superkaiyu/Robot_t-l-guider/README.md

# Robot téléguidé — 2 ESP32 + GPS + IHM, tout en WiFi

```
                          WiFi "ROBOT_ESP32" (créé par le robot, 192.168.4.1)
   ┌──────────────────────┐   UDP 4210, 25×/s : joystick + bouton     ┌───────────────────────────┐
   │ ESP32 MANETTE (XIAO)  │ ────────────────────────────────────────▶ │ ESP32 ROBOT (S3 N16R8)     │
   │ joystick (breadboard) │ ◀──────────────────────────────────────── │ driver moteurs + batterie  │
   └──────────────────────┘   réponse : qui pilote + position GPS    │                            │
                                                                     │  ▲ UART (fil TX du GPS)    │
   ┌──────────────────────┐   http://192.168.4.1  (page de l'IHM)    │  │                         │
   │ PC / téléphone        │ ◀──────────────────────────────────────── │ GPS Air530                 │
   │ IHM dans navigateur   │ ◀══ WebSocket port 81, 20×/s ══════════▶ │                            │
   └──────────────────────┘   télémétrie ⇄ commandes, ping           └───────────────────────────┘
```

- Le **robot** crée le réseau WiFi `ROBOT_ESP32` (mot de passe `motdepasse123`). Tout le monde s'y connecte : il n'y a besoin d'aucune box ni d'Internet.
- Le **GPS** est branché au robot par un fil série. Le robot décode la position et la diffuse en WiFi à l'IHM **et** à la Manette.
- La **Manette** envoie son joystick au robot 25×/s en UDP et reçoit en retour la position GPS (affichée dans son Moniteur Série).
- L'**IHM** est servie par le robot lui-même : ouvrir **http://192.168.4.1** suffit, elle se connecte toute seule en **WebSocket** (connexion permanente : le robot pousse la télémétrie 20×/s, les commandes partent dès qu'elles changent, la latence est affichée en haut à droite).

> **À propos du GPS :** un module GPS calcule sa position en *écoutant* les satellites (il n'émet rien vers eux). Cette partie est inévitable : **en intérieur, pas de position**. En revanche, tout le transport des données (GPS → ESP32 → IHM / Manette) passe uniquement par le fil série et le WiFi de l'ESP32. L'IHM affiche clairement si le module est **non détecté** (câblage), **en recherche** (câblé et OK, mais pas encore de ciel) ou a une **position acquise**.
> Pour tester toute la chaîne en intérieur, mettre `#define GPS_SIMULATION 1` dans `robot/robot.ino` : le robot envoie alors une fausse position (cercle de 10 m) marquée « Simulation ».

## Contenu

| Fichier | Rôle |
|---|---|
| `robot/robot.ino` | ESP32 **Robot** (ESP32-S3 N16R8) : point d'accès WiFi, GPS, moteurs, télémétrie, sert l'IHM |
| `robot/gps_detection.h`, `robot/gps_filtre.h`, `robot/gps_satellites.h` | Détection automatique du GPS, filtre de position, signal de chaque satellite |
| `robot/journal.h` | Enregistrement de chaque session dans la mémoire du robot |
| `robot/ws_serveur.h` | Mini serveur WebSocket (aucune bibliothèque à installer) |
| `robot/ihm_html.h` | IHM compressée embarquée dans le robot (**générée**, ne pas modifier à la main) |
| `robot/secrets_exemple.h` | Modèle pour les réseaux WiFi externes optionnels |
| `manette/manette.ino` | ESP32 **Manette** (Seeed XIAO ESP32S3) : joystick → robot, reçoit le GPS |
| `ihm/ihm.html` | Source de l'IHM (peut aussi être ouverte directement sur le PC) |
| `televerser_robot.bat`, `televerser_manette.bat`, `televerser_tout.bat`, `lister_esp32.bat` | Double-clic sous Windows : téléverse sur le bon ESP32 |
| `tools/televerser.py` | Le script appelé par les `.bat` (détecte quel port COM est quelle carte) |
| `tools/sessions.py`, `sessions_recuperer.bat` | Récupère les sessions du robot dans une base de données SQLite sur le PC |
| `tools/generer_ihm_h.py` | Régénère `robot/ihm_html.h` après une modification de l'IHM |

## Câblage

### Principe de la breadboard

- Les 5 trous d'une même rangée (a–e ou f–j) sont reliés entre eux. La rainure du milieu sépare les deux côtés.
- Les longues lignes des bords (rouge +, bleue −) sont des **rails** : un rail **3V3** (rouge) et un rail **masse** (bleu).
- La carte se pose à cheval sur la rainure : chaque broche tombe dans sa propre rangée. Pour la relier, plante un fil dans un des 4 autres trous de la même rangée, du même côté.

### ESP32 Robot : ESP32-S3 N16R8 (DevKitC-1)

Alimentation : **GND → rail bleu**, **3V3 → rail rouge**, câble USB-C sur le port marqué **UART** (PC, chargeur ou batterie externe).

| Élément | Branchement |
|---|---|
| **GPS** | **TX du module → GPIO14**, VCC → rail rouge, GND → rail bleu. Le RX du module reste libre. |
| LED de statut | GPIO21 → résistance 220–330 Ω → patte longue de la LED ; patte courte → rail bleu |
| Tension batterie | Pont diviseur : 30 kΩ entre le **+ batterie** et une rangée libre, 10 kΩ entre cette rangée et le rail bleu. Cette rangée → **GPIO1**. Le + batterie ne touche **jamais** directement un GPIO. |
| Courant | GPIO2. Sans capteur de courant, relier GPIO2 au rail bleu. |
| Carte moteur L298N | Voir le paragraphe suivant (6 fils sur P3 + la masse commune) |

Une roue tourne à l'envers ? Dans `robot.ino`, passe `INVERSER_ROUE_G` ou `INVERSER_ROUE_D` à `true`.

### Carte de commande moteur L298N (GEII Angoulême, module R1)

À choisir avec `#define DRIVER_MOTEUR DRIVER_L298` dans `robot.ino`. Le L298N contient deux ponts en H : **M1 = roue gauche** (sortie P2 « Moteur1 »), **M2 = roue droite** (sortie P4 « Moteur2 »). Pour chaque moteur, **EN** reçoit la PWM (la vitesse) et **I1 / I2** donnent le sens, comme dans la table de vérité du L298 :

| EN | I1 | I2 | Moteur |
|---|---|---|---|
| PWM | 1 | 0 | avant |
| PWM | 0 | 1 | arrière |
| 0 | x | x | roue libre (arrêt) |

**Connecteur P3 « Commande moteur »** (bornier vert à 6 points, dans l'ordre imprimé sur la carte) :

| Point P3 | Signal | Couleur conseillée | Broche ESP32-S3 |
|---|---|---|---|
| I2 (M2) | sens roue droite | vert | **GPIO18** |
| I1 (M2) | sens roue droite | jaune | **GPIO17** |
| EN (M2) | vitesse roue droite (PWM) | blanc | **GPIO9** |
| EN (M1) | vitesse roue gauche (PWM) | blanc | **GPIO8** |
| I1 (M1) | sens roue gauche | jaune | **GPIO15** |
| I2 (M1) | sens roue gauche | vert | **GPIO16** |

Sur la DevKitC-1, GPIO15, 16, 17, 18 et 8 sont côte à côte sur le même bord ; GPIO9 est trois broches plus loin (après GPIO3 et GPIO46).

**Connecteur P1 « Alimentation »** (GND · Vcc · GND) :

- **Vcc = 5 à 7 V au maximum, 6 V conseillés.** Sur cette carte, le même Vcc alimente les moteurs (VS) **et** la logique du L298 (VSS, 7 V maximum). La batterie 3S (12 V) ne doit donc **pas** aller directement sur Vcc : passer par un module abaisseur de tension (« buck », type LM2596, au moins 2 A) réglé sur 6 V, ou utiliser 4 piles AA, ou une alimentation de labo à 6 V avec limite de courant.
- Un GND reçoit le − de l'alimentation, **l'autre GND va au rail bleu de l'ESP32**. P3 n'a pas de masse : sans ce fil, les commandes ne passent pas.

**À savoir :**

- Les entrées du L298 acceptent directement le 3,3 V de l'ESP32 (niveau haut dès 2,3 V) : pas d'adaptateur de niveau.
- EN est tiré à la masse par 10 kΩ (R1, R4) : un fil EN débranché = moteur arrêté. C'est la première chose à vérifier si un moteur ne tourne pas.
- Le L298 perd environ 2 V : avec 6 V sur Vcc, le moteur reçoit environ 4 V. En dessous de 25 % de puissance le moteur siffle sans tourner ; le programme saute donc cette zone (`PUISSANCE_MIN_MOTEUR = 25`).
- PWM à 1 kHz (`FREQUENCE_PWM_MOTEURS`) : le L298 commute lentement et chaufferait plus vite. Le léger sifflement des moteurs est normal.
- Mesure de batterie : le pont diviseur reste branché sur le + de la batterie 3S (avant le module abaisseur). Avec 4 piles AA à la place, abaisser `SEUIL_SOUS_TENSION_PACK` (vers 4,4 V) et `SEUIL_SURTENSION_PACK` (vers 6,6 V) dans `robot.ino`, sinon l'IHM affiche « SOUS-TENSION » (les moteurs tournent quand même).
- Les diodes D1 à D8 (1N5819) protègent déjà le L298 des pointes de tension des moteurs.
- Les résistances R2/R3 et R5/R6 (mesure de courant du L298) ne sortent sur aucun connecteur : sans capteur séparé, relier GPIO2 au GND.

**Pour faire tourner un seul moteur** (premier essai) : P1 (6 V + GND), le fil de masse vers l'ESP32, les 3 fils de M1 (GPIO15 → I1, GPIO16 → I2, GPIO8 → EN) et le moteur sur P2. Robot sur cales, ouvrir le Moniteur Série (115200 bauds) et taper **`t`** : chaque moteur tourne 1,5 s en avant puis 1,5 s en arrière à 60 %. Ensuite, piloter depuis l'IHM.

**Autre driver** : avec un petit TB6612FNG ou DRV8833, mettre `#define DRIVER_MOTEUR DRIVER_TB6612` : GPIO15/16 → AIN1/AIN2 (roue gauche), GPIO17/18 → BIN1/BIN2 (roue droite), PWM à 20 kHz, VCC/STBY/PWMA/PWMB (TB6612) ou nSLEEP (DRV8833) au 3V3.

Sans batterie branchée sur le pont diviseur, l'IHM affiche la batterie « NON BRANCHÉE » (pas d'alarme).

**Arduino IDE (Robot)** : carte **ESP32S3 Dev Module** ; *USB CDC On Boot : Disabled* (le Moniteur Série passe par le port UART) ; *Flash Size : 16MB* ; *PSRAM : OPI PSRAM* ; *Partition Scheme : Huge APP (3MB No OTA/1MB SPIFFS)* (il faut un espace de fichiers pour enregistrer les sessions). Le même `robot.ino` fonctionne encore sur une XIAO ESP32S3 : le brochage est choisi selon la carte sélectionnée.

**Détection automatique du GPS** : au démarrage, le Robot cherche tout seul sur quelle broche arrive le fil TX du GPS (**GPIO14**, puis les broches libres voisines GPIO13, 12, 11, 10, 4, 5, 6, 7) et à quelle vitesse il parle (9600, 115200, 38400, 57600, 19200, 4800 bauds). Il vérifie que ce sont de vraies trames GPS (NMEA avec somme de contrôle), puis retient la combinaison trouvée pour le démarrage suivant. Si le GPS est débranché puis rebranché, il le retrouve (nouvel essai toutes les 10 s). Le résultat s'affiche :

- dans le Moniteur Série du robot : `[GPS] ✅ Module GPS détecté sur GPIO14 à 9600 bauds.` ;
- dans l'IHM, onglet **GPS** (« Branché sur : GPIO14 · 9600 bauds »), avec un bouton **Relancer la détection du GPS** ;
- avec `lister_esp32.bat` : `COM5  ROBOT … GPS : module OK, recherche des satellites — branché sur GPIO14 à 9600 bauds`.

Commandes à taper dans le Moniteur Série du robot (115200 bauds) : `?` identité + état du GPS, `g` afficher les trames GPS brutes (marche/arrêt), `d` relancer la détection, `t` tester les moteurs un par un.

### Modules LMD18200T (un par roue)

Réglage actuel du programme : `#define DRIVER_MOTEUR DRIVER_LMD18200`. Le LMD18200T est un pont en H complet (3 A, jusqu'à 55 V) : il faut **un module par roue**. Les broches de l'ESP32 sont les mêmes que pour la carte L298N, seuls leurs rôles changent.

| Signal du module | Roue gauche | Roue droite | Rôle |
|---|---|---|---|
| DIR (patte 3 du LMD18200) | **GPIO15** | **GPIO17** | sens : 1 = avant, 0 = arrière |
| BRAKE (patte 4) | **GPIO16** | **GPIO18** | 0 = roule, 1 avec PWM à 0 = roue libre |
| PWM (patte 5) | **GPIO8** | **GPIO9** | vitesse |
| GND (patte 7) | GND de l'ESP32 | GND de l'ESP32 | masse commune obligatoire |
| VS (patte 6) | + 12 V | + 12 V | puissance des moteurs |
| OUTPUT 1 et 2 (pattes 2 et 10) | moteur gauche | moteur droit | |

Pattes du LMD18200T (boîtier à 11 pattes, marquage face à soi, de gauche à droite) : 1 bootstrap 1 · 2 sortie 1 · 3 DIR · 4 BRAKE · 5 PWM · 6 VS · 7 GND · 8 mesure de courant · 9 alarme température · 10 sortie 2 · 11 bootstrap 2. Les deux condensateurs bleus (10 nF, pattes 1-2 et 10-11) sont déjà soudés sur le module. Pour savoir quel point des connecteurs du module va à quelle patte, lire la sérigraphie ou tester au multimètre (mode bip, module débranché).

**Alimentation** : VS entre 12 et 55 V. En dessous d'environ 10 V, le LMD18200 se coupe tout seul (protection). Une batterie 3S chargée (11 à 12,6 V) convient ; pour les tests, une alimentation de labo à 12 V limitée à 1 ou 2 A. Les moteurs reçoivent presque toute la tension : avec des moteurs 6 V, garder « Puissance max » à 50 % au plus dans l'IHM.

**À savoir** : les entrées acceptent le 3,3 V de l'ESP32 (niveau haut dès 2 V). PWM à 20 kHz, inaudible. À l'arrêt, le programme met BRAKE à 1 et PWM à 0 : roue libre. Mesure de courant facultative : la patte 8 sort 377 µA par ampère dans la résistance du module ; reliée à GPIO2, régler `COURANT_AMPERES_PAR_VOLT = 1 / (0.000377 × R)` (par exemple 1,2 pour R = 2,2 kΩ). Test : taper `t` dans le Moniteur Série, robot sur cales.

### ESP32 Manette : Seeed XIAO ESP32S3

La XIAO se pose à cheval sur la rainure (D0 à D10 sont imprimés sur la carte), alimentée par son propre câble USB-C.

| Élément | Broche XIAO | GPIO |
|---|---|---|
| Joystick +5V / VCC | **3V3** (même si le module indique 5V) | — |
| Joystick GND | GND | — |
| Joystick VRx | D2 | 3 |
| Joystick VRy | D10 | 9 |
| Joystick SW (bouton) | D6 | 43 |
| LED statut (via 220–330 Ω, cathode vers GND) | D5 | 6 |

**Arduino IDE (Manette)** : carte **XIAO_ESP32S3**, *USB CDC On Boot : Enabled*.

### Ordre conseillé

1. Câble le Robot **sans** les moteurs ni la batterie, téléverse-le et vérifie l'IHM sur http://192.168.4.1.
2. Câble la Manette et vérifie qu'elle se connecte au robot (LED fixe, pastille « ESP32 Manette » verte).
3. Branche la carte moteur et les moteurs en dernier, avec une alimentation réglée à 6 V et une limite de courant basse, puis tape `t` dans le Moniteur Série pour les tester.

## Téléverser les deux ESP32 (un seul port USB du PC)

Branche les deux cartes sur un **hub USB** (ou deux ports) : le Robot par son port USB-C **UART**, la Manette par son USB-C. Chaque carte a un numéro de série unique : Windows lui donne **son propre port COM** (par ex. COM5 et COM7), toujours le même ensuite. Rien à régler dans les cartes.

**Méthode automatique (recommandée)** — il faut seulement Python (https://www.python.org, cocher « Add to PATH ») et l'Arduino IDE 2 déjà utilisé :

1. Double-clic sur **`televerser_tout.bat`** (ou `televerser_robot.bat` / `televerser_manette.bat`).
2. Le script demande « ? » à chaque carte, qui répond `ID=ROBOT` ou `ID=MANETTE`, puis compile et téléverse le bon programme sur le bon port. Il utilise l'`arduino-cli` intégré à l'Arduino IDE : mêmes cartes, mêmes bibliothèques, et la bonne carte pour chaque programme (ESP32-S3 N16R8 pour le Robot, XIAO pour la Manette).
3. La toute première fois (cartes pas encore programmées), il te demande laquelle est laquelle, puis s'en souvient (`tools/cartes_esp32.json`).

`lister_esp32.bat` affiche simplement quel COM est le Robot et lequel est la Manette. En ligne de commande : `python tools/televerser.py moniteur robot` ouvre le Moniteur Série d'une carte.

**Méthode manuelle dans l'Arduino IDE** : ouvre `robot.ino` et `manette.ino` dans **deux fenêtres** de l'IDE. Dans chaque fenêtre, choisis la bonne carte (**ESP32S3 Dev Module** pour le Robot, **XIAO_ESP32S3** pour la Manette, réglages ci-dessus) et le port de la bonne carte (*Outils › Port*). Pour savoir quel COM est quelle carte, ouvre le Moniteur Série (115200 bauds), tape `?` puis Entrée : la carte répond `ID=ROBOT` ou `ID=MANETTE`. Tu peux aussi débrancher une carte et regarder quel port disparaît.

> ⚠️ Utilise le bouton **Téléverser (→)** et non **Déboguer** (icône insecte). Le débogueur lance OpenOCD sur l'interface JTAG, d'où l'erreur `LIBUSB_ERROR_ACCESS … esp_usb_jtag: could not find or open device` : ce n'est pas nécessaire pour programmer la carte.
>
> Si un téléversement échoue : ferme le Moniteur Série ouvert sur ce port. Si la carte ne répond plus, maintiens **BOOT**, appuie sur **RESET**, relâche **BOOT**, puis relance.

## Mise en route

1. **Arduino IDE** : installer le paquet de cartes *esp32* (Espressif) et la bibliothèque **TinyGPSPlus** (Mikal Hart). Réglages des cartes : voir « Câblage » ci-dessus.
2. *(Optionnel)* copier `robot/secrets_exemple.h` en `robot/secrets.h` et y mettre les mots de passe de tes réseaux (box, partage de connexion, WIFI-UP). Ce fichier n'est jamais envoyé sur GitHub. Sans lui, le robot fonctionne avec son seul point d'accès.
3. Téléverser les deux cartes (voir ci-dessus). *Ne pas toucher le joystick pendant la première seconde : sa position de repos est calibrée au démarrage.*
4. Connecter le PC ou le téléphone au WiFi **ROBOT_ESP32**, puis ouvrir **http://192.168.4.1**.

Ce qu'on doit voir :

- Moniteur Série du robot : `[WiFi] ESP32 Manette connectée !`, `[WebSocket] IHM n°0 connectée`, puis toutes les 5 s une ligne `[GPS] etat=...`.
- Moniteur Série de la Manette : `[Robot] Liaison établie : commandes et GPS échangés.` puis chaque seconde la position GPS reçue.
- LED de la Manette : **fixe** = tout communique ; clignote lent = WiFi OK mais robot muet ; clignote vite = WiFi introuvable.
- IHM : les pastilles en haut (Robot, ESP32 Manette, GPS, latence ≈ quelques ms et « WebSocket · 20 msg/s »).

## L'IHM

- **Piloter depuis le PC** : PC connecté au WiFi `ROBOT_ESP32`, page http://192.168.4.1, puis **joystick virtuel** à glisser à la souris (ou au doigt sur téléphone), **clavier** (flèches ou ZQSD, les touches s'allument ; `+` / `−` pour la puissance ; *Espace* = arrêt d'urgence), ou **manette USB** branchée au PC. Si le robot ne suit pas, une ligne orange sous le joystick dit pourquoi (mode démo, pas de liaison, manette prioritaire, arrêt d'urgence).
- **Démarrage progressif des moteurs** : la puissance monte en 250 ms au lieu d'un coup, pour éviter la chute de tension qui faisait redémarrer l'ESP32. S'arrêter reste immédiat.
- **Barres Roue G / Roue D** : la puissance réellement appliquée par le robot (pas seulement celle demandée).
- **Qui pilote** : IHM, ESP32 Manette ou arrêt d'urgence, en direct.
- Onglets **Vue d'ensemble**, **GPS** (position, signal de chaque satellite et carte du ciel, trajet, liens OpenStreetMap / Google Maps), **Batterie**, **Roues**, **Système** (diagnostic des coupures et des redémarrages), **Sessions** (récapitulatif de chaque session, voir plus bas).
- Une petite coupure WiFi ne remet plus tout à zéro : l'IHM affiche « Signal faible » et grise les valeurs. La liaison n'est déclarée perdue qu'après 6 s.
- Si le robot redémarre, un bandeau l'indique avec la cause (par exemple « chute de tension »).
- Aucune bibliothèque externe : tout fonctionne sans Internet (seule la carte OpenStreetMap optionnelle en a besoin). Utilisable aussi sur téléphone.
- Si le robot a encore un ancien firmware (sans WebSocket), l'IHM repasse automatiquement en HTTP (« HTTP (secours) »).
- Robot non connecté : **mode démo** qui simule le robot.

## Qui pilote ?

Plusieurs sources peuvent être connectées en même temps. Le robot choisit, à chaque instant :

1. **Arrêt d'urgence** : bouton du joystick de la Manette, bouton rouge / *Espace* dans l'IHM, ou bouton B de la manette USB → coupe tout.
2. **ESP32 Manette**, dès que son stick est écarté du centre.
3. **IHM**.

Une source au repos ne bloque jamais les autres. Sans commande fraîche depuis 500 ms, les moteurs sont coupés.

## Protocoles

| Liaison | Format |
|---|---|
| Manette → Robot (UDP 4210) | `M,<rg>,<rd>,<jx>,<jy>,<bouton 0/1>,<rssi>` (rg/rd de -100 à 100) |
| Robot → Manette | `OK;pilote=...;gps=...;fix=0/1;lat=...;lon=...;sat=...` |
| IHM → Robot (WebSocket 81) | `c,<rg>,<rd>` commande · `stop` arrêt d'urgence · `p,<n>` ping · `h,<s depuis 1970>` heure du PC |
| Robot → IHM | JSON de télémétrie 20×/s · `P,<n>` réponse au ping |
| HTTP (secours / outils) | `/` IHM · `/cmd?src=ihm&rg=..&rd=..[&stop=1]` · `/telemetrie` · `/gps` · `/gps-detecter` · `/wifiup` · `/aide` · `/sessions` · `/session?id=N` · `/session-supprimer?id=N` (POST) · `/heure?e=..` |

## Sessions et base de données

Une **session**, c'est tout ce qui se passe entre l'allumage et l'extinction du robot. Le robot l'enregistre lui-même dans sa mémoire flash (`/sessions/000042.csv`, 42 = numéro de démarrage), même si aucune IHM n'est ouverte :

- une mesure par seconde quand le robot roule ou que le GPS se déplace, toutes les 5 s sinon : position GPS, satellites, HDOP, vitesse, tension et courant batterie, consommation, puissance des roues, qui pilote, présence de l'IHM et de la manette, signal WiFi le plus faible ;
- les événements : arrêt d'urgence, changement de pilote, manette / IHM connectée ou perdue, appareil qui quitte le WiFi, position GPS trouvée ou perdue, alerte batterie ;
- l'heure réelle, donnée par l'IHM à la connexion (le robot n'a pas d'horloge) ou lue sur le GPS.

L'écriture se fait toutes les 10 s : on perd au plus les 10 dernières secondes quand on coupe l'alimentation. La mémoire garde environ 60 sessions ; quand elle est pleine, les plus anciennes sont effacées.

**Dans l'IHM**, onglet **Sessions** : la liste, et pour chaque session un récapitulatif (durée, temps de conduite manette / IHM, distance et vitesse max GPS, batterie début → fin, consommation, % du temps avec une position GPS, arrêts d'urgence et coupures), le trajet, la courbe de batterie et la liste des événements. Le bouton *Télécharger le CSV* enregistre le fichier sur le PC, et *Ouvrir un fichier CSV* réaffiche plus tard une session déjà téléchargée. Pendant le téléchargement d'une session (1 à 2 s) le robot s'arrête par sécurité.

**Base de données sur le PC** : PC connecté au WiFi du robot, double-clic sur **`sessions_recuperer.bat`**. Toutes les nouvelles sessions sont copiées dans `sessions/sessions.db` (SQLite) et leurs CSV dans `sessions/csv/`. Le dossier `sessions/` reste sur le PC (il n'est pas envoyé sur GitHub). En ligne de commande :

```
python tools/sessions.py                 # récupère les nouvelles sessions du robot
python tools/sessions.py liste           # toutes les sessions de la base
python tools/sessions.py recap 42        # récapitulatif détaillé de la session 42
python tools/sessions.py importer f.csv  # ajoute un CSV téléchargé depuis l'IHM
python tools/sessions.py exporter 42     # mesures de la session 42 en CSV (pour Excel)
```

La base contient trois tables : `sessions` (une ligne de récapitulatif par session), `mesures` et `evenements`. Elle s'ouvre aussi avec *DB Browser for SQLite* pour faire ses propres requêtes. L'IHM et `sessions.py` utilisent les mêmes règles de calcul : une distance n'est comptée qu'au-delà de 2 m entre deux positions (bruit du GPS), et un trou de plus de 10 s dans l'enregistrement est ignoré.

Si l'onglet Sessions indique que le robot n'a pas d'espace pour enregistrer, c'est le *Partition Scheme* : choisir **Huge APP (3MB No OTA/1MB SPIFFS)** puis téléverser à nouveau (`televerser_robot.bat` le fait tout seul).

## Modifier l'IHM

Modifier `ihm/ihm.html`, puis `python tools/generer_ihm_h.py` et re-téléverser le robot. (`televerser_robot.bat` régénère le fichier automatiquement.)

## Dépannage GPS

| L'IHM affiche | Signification | Que faire |
|---|---|---|
| **Détection du module…** | Le robot essaie les broches / vitesses une par une | Attendre quelques secondes |
| **Module non détecté** | Rien reçu sur aucune des broches essayées, à aucune vitesse | Vérifier le fil TX du GPS → GPIO14 du Robot, VCC → 3V3 (ou 5V selon le module), GND commun, LED du module allumée |
| **Données illisibles** | Des caractères arrivent mais ne forment jamais de trames NMEA valides | Masse (GND) commune, vitesse du module inhabituelle |
| **Recherche · N satellites entendus** | Câblage OK, le module communique, pas encore de position | Aller dehors / près d'une fenêtre, attendre 1 à 5 min au premier démarrage |
| **Position acquise** | Tout fonctionne | — |

**Le tracé GPS bougeait tout seul, robot immobile ?** C'est normal pour un GPS : chaque mesure varie de 2 à 5 m dehors, et de 10 à 20 m en intérieur. Le robot filtre maintenant la position (`robot/gps_filtre.h`) :
- **moteurs arrêtés** : la position est moyennée pendant 30 s puis **figée**. Le trajet ne bouge plus, même si le GPS dérive de plusieurs dizaines de mètres (fréquent en intérieur) ou annonce une fausse vitesse de 1 à 3 km/h ;
- **mesures imprécises (HDOP > 8) et sauts aberrants** : ignorés ;
- **robot qui roule (moteurs), ou GPS vraiment porté à la main** (plus de 3,5 km/h pendant 5 s et au moins 4 m parcourus) : le trajet suit.

Dans l'onglet GPS, les points pâles montrent les mesures brutes (le bruit) ; la ligne est le trajet filtré.

## Précision du GPS

L'onglet **GPS › Réception des satellites** montre la force du signal (dB-Hz) de chaque satellite et sa position dans le ciel :

| Signal | Signification |
|---|---|
| ≥ 35 dB-Hz (vert) | très bon |
| 25 à 35 (orange) | moyen |
| < 25 (rouge) | trop faible pour servir |

Il faut au moins **4 satellites au-dessus de 30 dB-Hz** pour obtenir une position, et **6 ou plus** pour qu'elle soit précise.

Ce qui améliore la précision :

1. **Ciel dégagé** : loin des murs, des arbres et des toits. En intérieur, les signaux sont trop faibles.
2. **Antenne vers le ciel** : la face plate (céramique) du module vers le haut, jamais couverte par la main.
3. **GPS éloigné de l'électronique** : au moins 10 cm de l'ESP32, des moteurs et des câbles USB. Leur bruit électrique brouille le GPS (signaux qui chutent dans l'onglet).
4. **Temps** : laisse le GPS allumé 10 à 15 min. La précision s'améliore à mesure qu'il reçoit les informations des satellites.
5. **Alimentation stable** : chaque redémarrage du robot oblige le GPS à tout recommencer.
6. **Robot immobile** : la position est moyennée pendant 60 s, en donnant plus de poids aux mesures précises (HDOP faible, beaucoup de satellites).

Même dans de bonnes conditions, un module GPS d'entrée de gamme reste précis à **2 à 5 m** environ.

### Pourquoi le tracé partait à 100 m alors que le GPS ne bougeait pas

Avec des signaux sous 25 dB-Hz (tout en rouge dans l'onglet), le module calcule quand même une position et annonce un HDOP correct, mais cette position peut être fausse de 50 à 150 m et se promener. Ajoute à cela les premières positions après l'allumage (souvent très fausses) et les redémarrages du robot, et on obtient de grandes lignes droites sur le tracé. Le filtre du robot (`robot/gps_filtre.h`) fait maintenant :

- **au démarrage**, il attend que 10 mesures de suite soient d'accord entre elles (60 s au plus) et garde leur médiane (badge « stabilisation ») ;
- **signal faible** (moins de 4 satellites à 25 dB-Hz ou plus) : position figée tant que les moteurs ne tournent pas, précision affichée « ± 25 m (signal faible) » ;
- **sauts impossibles** : une mesure plus loin que ce qu'on peut parcourir à 3 m/s est ignorée. Si 10 mesures de suite sont ignorées et d'accord entre elles, le robot a vraiment été déplacé et on repart de là ;
- **porté à la main** : reconnu seulement si les mesures récentes se sont vraiment éloignées (plus de 8 m) et que le GPS mesure une vitesse.

L'IHM ne relie plus deux points séparés de plus de 30 m, ni l'avant et l'après d'un redémarrage : le trajet est coupé en morceaux au lieu de tracer une grande ligne droite.

**Le vrai remède reste le ciel dégagé** : dehors, loin des murs, antenne vers le haut. Aucun filtre ne peut retrouver la bonne position à partir de signaux trop faibles ; il peut seulement éviter d'afficher n'importe quoi.

## Coupures WiFi : trouver la cause

L'onglet **Système** de l'IHM affiche le diagnostic : coupures, signal WiFi de chaque appareil, redémarrages du robot et leur cause, et des conseils adaptés. Les causes les plus fréquentes :

| Ce que montre l'onglet Système | Cause | Solution |
|---|---|---|
| Redémarrages, cause « chute de tension » | Alimentation trop faible (pics de courant du WiFi ou des moteurs) | Batterie externe de qualité, câble USB court et épais. En dernier recours, baisser `PUISSANCE_WIFI` dans `robot.ino`. |
| Redémarrages, cause « mise sous tension » | La batterie externe se coupe toute seule (consommation trop faible) | Batterie externe sans arrêt automatique, ou alimentation par le PC |
| Signal en dessous de −75 dBm | Trop loin, ou signal bloqué (le corps humain absorbe le WiFi) | Rapprocher le PC, ne pas tenir le robot contre soi, ne pas couvrir l'antenne (bout de la carte) |
| Coupures sans redémarrage ni signal faible | Windows quitte ROBOT_ESP32 (réseau sans Internet) pour un autre réseau connu | Désactiver la connexion automatique des autres réseaux WiFi pendant les essais |

Quand le WiFi est faible, le robot n'abandonne plus la connexion : il saute simplement les mesures qui ne passent pas et reprend dès que possible.
