superkaiyu/Robot_t-l-guider/ecran_global_pc.png

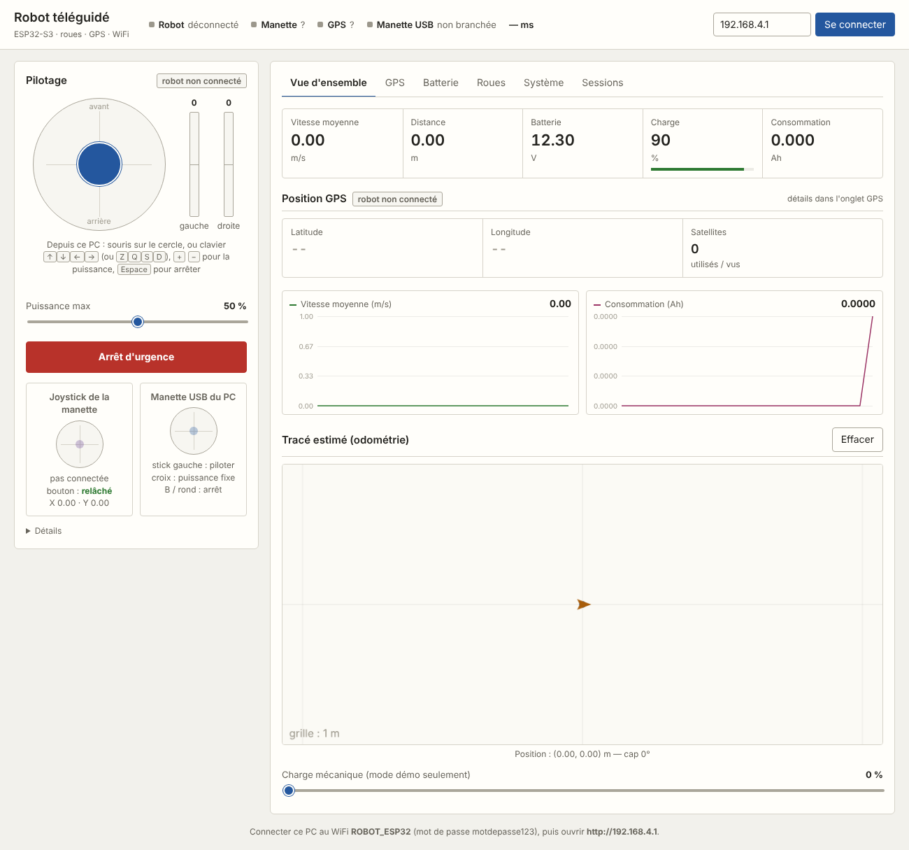
ecran_global_pc.png
