superkaiyu/Robot_t-l-guider/robot/ihm_html.h

// FICHIER GÉNÉRÉ AUTOMATIQUEMENT par tools/generer_ihm_h.py — ne pas modifier à la main.
// Source : ihm/ihm.html (compressée en gzip). Relancer `python tools/generer_ihm_h.py`
// après chaque modification de l'IHM.
#pragma once
#include <pgmspace.h>

// 120448 octets de HTML -> 31375 octets compressés
const size_t IHM_HTML_GZ_TAILLE = 31375;
const uint8_t IHM_HTML_GZ[] PROGMEM = {
  0x1f, 0x8b, 0x08, 0x00, 0x00, 0x00, 0x00, 0x00, 0x02, 0x03, 0xdc, 0xbd, 0x5d, 0x77, 0xdb, 0x48, 0x96, 0x20, 0xf8, 0x9e,
  0xbf, 0x02, 0x56, 0xbb, 0x92, 0x44, 0x9a, 0xa4, 0x48, 0xea, 0xc3, 0xb6, 0x68, 0xc9, 0x2b, 0x4b, 0x4a, 0xa7, 0x2a, 0x6d,
  0x4b, 0x6d, 0xc9, 0xae, 0xcc, 0x76, 0x79, 0x2d, 0x90, 0x0c, 0x91, 0x48, 0x93, 0x04, 0x13, 0x00, 0x29, 0x29, 0x5d, 0xda,
  0x53, 0x4f, 0xbd, 0x53, 0x6f, 0x3b, 0x3d, 0x7d, 0xce, 0x9c, 0x79, 0xeb, 0x33, 0x0f, 0xbb, 0xe5, 0xd9, 0x97, 0xda, 0xa7,
  0x79, 0xd8, 0xb7, 0xd2, 0x3f, 0xa9, 0x5f, 0xb2, 0xf7, 0x23, 0x22, 0x10, 0x00, 0x02, 0x20, 0x65, 0x3b, 0x6b, 0xa6, 0x37,
  0xbb, 0xcb, 0x02, 0x81, 0xf8, 0x8e, 0x1b, 0x37, 0xee, 0xf7, 0x7d, 0x74, 0x67, 0xff, 0x68, 0xef, 0xf4, 0xc7, 0xe3, 0x03,
  0x67, 0x18, 0x8f, 0x47, 0x3b, 0x5f, 0x3d, 0xc2, 0x3f, 0xce, 0xc8, 0x9b, 0x0c, 0xb6, 0x57, 0xce, 0xc3, 0x15, 0x7c, 0x21,
  0xbc, 0xfe, 0xce, 0x57, 0x0e, 0xfc, 0xf7, 0x68, 0x2c, 0x62, 0xcf, 0xe9, 0x0d, 0xbd, 0x30, 0x12, 0xf1, 0xf6, 0xca, 0xab,
  0xd3, 0x6f, 0xeb, 0x0f, 0x56, 0xcc, 0x4f, 0x13, 0x6f, 0x2c, 0xb6, 0x57, 0xe6, 0xbe, 0xb8, 0x98, 0x06, 0x61, 0xbc, 0xe2,
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
  0xcd, 0x7e, 0xb7, 0xbb, 0x79, 0x9e, 0x82, 0x0d, 0xd1, 0x7c, 0xe8, 0xad, 0xf7, 0x4c, 0xd8, 0x10, 0x0f, 0xee, 0xaf, 0x6f,
  0xa6, 0x61, 0xa3, 0xbb, 0xfe, 0xd0, 0x83, 0x31, 0xd9, 0x26, 0xc7, 0xf0, 0x91, 0xf4, 0x24, 0xe1, 0x63, 0xa3, 0xd7, 0xed,
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
};
