superkaiyu/Robot_t-l-guider/(commit log)

2026-09-28 Relier Robot, Manette, GPS et IHM via le WiFi de l'ESP32 robot
    - Robot : point d'accès ROBOT_ESP32 toujours actif, réseau externe
    optionnel non bloquant et sur le même canal (la Manette n'est plus
    déconnectée), mots de passe déplacés dans secrets.h (non versionné).
    - GPS : diagnostic complet (module absent / illisible / recherche / fix),
    satellites visibles, dernière position connue, altitude, vitesse, HDOP,
    mode GPS_SIMULATION pour tester la chaîne en intérieur.
    - Pilotage multi-sources (Manette > IHM) avec arrêt d'urgence partagé ;
    joystick local du robot désactivé par défaut (broches flottantes).
    - Manette : envoie aussi la position du stick, reçoit la position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
    [generer_ihm_h.py, ihm_html.h, manette.ino, robot.ino, secrets_exemple.h]
2026-09-28 IHM temps réel et redessinée, Manette en UDP, téléversement des 2 ESP32
    - Robot : mini serveur WebSocket intégré (ws_serveur.h, sans bibliothèque)
    qui pousse la télémétrie 20x/s et reçoit les commandes instantanément ;
    envois non bloquants pour que le chien de garde moteurs ne soit jamais
    suspendu par un navigateur disparu. IHM servie compressée (gzip).
    - Manette : liaison UDP à 25 Hz (plus de requête HTTP bloquante par
    commande), réponse du robot avec la position GPS.
    - Les deux firmwares répondent "ID=ROBOT" / "ID=MANETTE" à "?" sur le
    port série.
    - tools/televerser.py + fichiers .bat : avec les deux cartes branchées
    (hub USB), détecte quel port COM est que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
    [generer_ihm_h.py, ihm_html.h, manette.ino, robot.ino, televerser.py, ws_serveur.h]
2026-09-28 Détection automatique du GPS sur l'ESP32 Robot
    - gps_detection.h : balaye les broches libres (D7, D6, D2, D10) et les
    vitesses courantes (9600 à 115200 bauds) sans bloquer la boucle, et ne
    valide que de vraies trames NMEA (somme de contrôle). La combinaison
    trouvée est mémorisée en flash ; nouvel essai toutes les 10 s si le
    GPS est absent ou débranché.
    - Robot : nouvel état "detection", broche/vitesse trouvées dans la
    télémétrie, route /gps-detecter, commandes série ? (identité + GPS),
    g (trames brutes) et d (relancer la détection).
    - IHM : état de détection, ligne "Branché sur", bouton "Relancer la
    détection du GPS".
    - televerser.py : la liste des cartes in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
2026-09-28 Filtre GPS : le tracé ne bouge plus quand le robot est immobile
    Même immobile, un GPS varie de 2 à 5 m dehors (10 à 20 m en intérieur),
    et l'IHM dessinait ce bruit comme un déplacement.
    - gps_filtre.h : mesures imprécises (HDOP > 8, < 4 satellites) et
    sauts aberrants ignorés ; robot immobile (moteurs arrêtés et vitesse
    GPS faible) -> position figée puis moyennée ; en mouvement (moteurs
    ou GPS porté à la main) -> léger lissage.
    - Robot : envoie la position filtrée (IHM et Manette), plus la mesure
    brute, l'état immobile, le nombre de mesures moyennées et la précision.
    - IHM : point de trajet ajouté seulement si le robot bouge (> 2 m),
    mesures brutes affichées en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
2026-09-28 Filtre GPS : plus de faux déplacements quand le robot est à l'arrêt
    En intérieur, le GPS dérive lentement de plusieurs dizaines de mètres
    et annonce une fausse vitesse de 1 à 3 km/h : le filtre croyait alors
    le robot porté à la main (seuil de 2 km/h) et le trajet s'allongeait.
    - Sans moteurs, le robot n'est considéré comme déplacé que s'il est
    vraiment porté : > 3,5 km/h pendant 5 mesures ET > 4 m parcourus.
    - À l'arrêt : moyenne des 30 premières mesures puis position figée
    jusqu'au prochain mouvement ; la dérive lente et les sauts ne
    déplacent plus la position.
    - IHM : « position figée » / « moyenne en cours (n/30) ».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
2026-10-13 Robot sur ESP32-S3 N16R8 : nouveau brochage
    - Brochage choisi selon la carte sélectionnée dans l'IDE : ESP32-S3
    N16R8 ("ESP32S3 Dev Module") par défaut, XIAO ESP32S3 toujours prise
    en charge. N16R8 : moteurs GPIO15/16 (AIN1/AIN2) et 17/18 (BIN1/BIN2),
    LED GPIO21, batterie GPIO1 (pont 30k/10k), courant GPIO2, GPS sur
    GPIO14 (broches libres voisines essayées ensuite, jamais 43/44 du
    port UART).
    - Moteurs : PWM à 20 kHz (plus de sifflement), inversion de sens par
    roue configurable.
    - Mesures avec analogReadMilliVolts (étalonnage d'usine), état
    batterie "ABSENTE" quand rien n'est branché sur le pont diviseur.
    - Joystick local du robot supprimé (le joystick est sur la Manet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
2026-10-21 Diagnostic des coupures, signal des satellites, liaison plus robuste
    - WebSocket : un envoi partiel (WiFi faible) n'entraîne plus la
    fermeture de la connexion ; la fin de la trame est envoyée dès que
    possible et les trames suivantes sont sautées en attendant. Avant,
    un signal faible provoquait des déconnexions/reconnexions en boucle.
    - Robot : cause du dernier redémarrage (dont chute de tension),
    compteurs de démarrages et de chutes de tension en flash, signal
    WiFi de chaque appareil connecté, déconnexions du point d'accès,
    mémoire libre, puissance WiFi réglable, mode AP seul sans réseau
    externe.
    - gps_satellites.h : décodage des trames GSV (signal, élévation,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
2026-11-02 IHM plus sobre + journal des sessions et base de données
    - IHM redessinée : thème clair type papier (sombre automatique), sans
    dégradés, ombres ni émojis, textes plus courts et naturels.
    - Nouvel onglet Sessions : liste des sessions enregistrées par le robot,
    récapitulatif (durée, conduite, distance, batterie, GPS, incidents),
    trajet, courbe de batterie, événements, téléchargement / ouverture CSV.
    - Robot : journal.h enregistre chaque session dans LittleFS (mesures +
    événements + heure réelle), routes /sessions, /session, /heure,
    /session-supprimer. Nécessite le schéma de partition Huge APP.
    - tools/sessions.py + sessions_recuperer.bat : récupère les sessions da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
2026-11-02 GPS : plus de grands sauts sur le tracé + pilotage depuis le PC plus clair
    GPS (robot/gps_filtre.h réécrit) :
    - démarrage : attend 10 mesures d'accord entre elles et garde la médiane
    (état « stabilisation » dans l'IHM) ;
    - signal faible (moins de 4 satellites à 25 dB-Hz) : position figée,
    précision affichée au moins 25 m ;
    - sauts impossibles (> incertitude + 3 m/s) ignorés ; reprise ailleurs
    seulement après 10 mesures cohérentes, signalée à l'IHM (gpsSauts) ;
    - « porté à la main » reconnu sur un vrai éloignement, pas sur la vitesse seule.
    IHM : le tracé est coupé (pas de ligne droite) après un saut de plus de
    30 m, une reprise ou un redémarrage du robot.
    Pil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
2026-11-02 Retire une capture d'écran de test ajoutée par erreur
    Claude-Session: https://claude.ai/code/session_01PowvnyJmBTF3jNaZuiEMYT
2026-11-02 IHM : le clavier pilote aussi après avoir tapé l'adresse du robot
    Après « adresse + Entrée », le curseur restait dans le champ d'adresse :
    les flèches ne pilotaient pas et Espace pouvait cliquer « Déconnecter »
    au lieu de faire l'arrêt d'urgence. Le champ est quitté à la connexion,
    ↑ ↓ et Échap rendent aussi le clavier au pilotage.
    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
2026-11-03 Robot : prise en charge de la carte de commande moteur L298N du GEII
    - DRIVER_L298 = 1 (par défaut) : par moteur, EN reçoit la PWM et I1/I2
    donnent le sens (M1 = roue gauche : GPIO15/16/8, M2 = roue droite :
    GPIO17/18/9). PWM à 1 kHz, zone morte du L298 sautée (25 %).
    - DRIVER_L298 = 0 garde l'ancien câblage TB6612 / DRV8833.
    - Commande « t » du Moniteur Série : test de chaque moteur dans les deux
    sens, sans IHM ni manette.
    - README : branchement de P1 (Vcc 5 à 7 V maximum, masse commune) et du
    bornier P3, essai avec un seul moteur.
    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
2026-11-09 Robot : corrige l'erreur de compilation « CommandeSource was not declared »
    L'Arduino IDE ajoute les prototypes de toutes les fonctions juste avant la
    première fonction du fichier. noterEvenement() était placée avant la
    déclaration de CommandeSource, SourcePilote et EtatSTA : les prototypes se
    retrouvaient avant ces types. Elle est déplacée après eux, avec un
    commentaire pour ne plus écrire de fonction plus haut.
    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
2026-11-12 Robot : prise en charge des modules moteur LMD18200T
    - DRIVER_MOTEUR choisit le driver : DRIVER_LMD18200 (par défaut),
    DRIVER_L298 (carte GEII) ou DRIVER_TB6612.
    - LMD18200 : un module par roue, mode signe / amplitude. Mêmes broches que
    la carte L298N (GPIO15/17 = DIR, GPIO16/18 = BRAKE, GPIO8/9 = PWM),
    PWM à 20 kHz, roue libre à l'arrêt (BRAKE = 1, PWM = 0).
    - README : branchement et alimentation des modules LMD18200.
    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
